mcoirault/arduboy/arduboy.kicad_pcb

## KiCad design arduboy.kicad_pcb (2023-04-20)

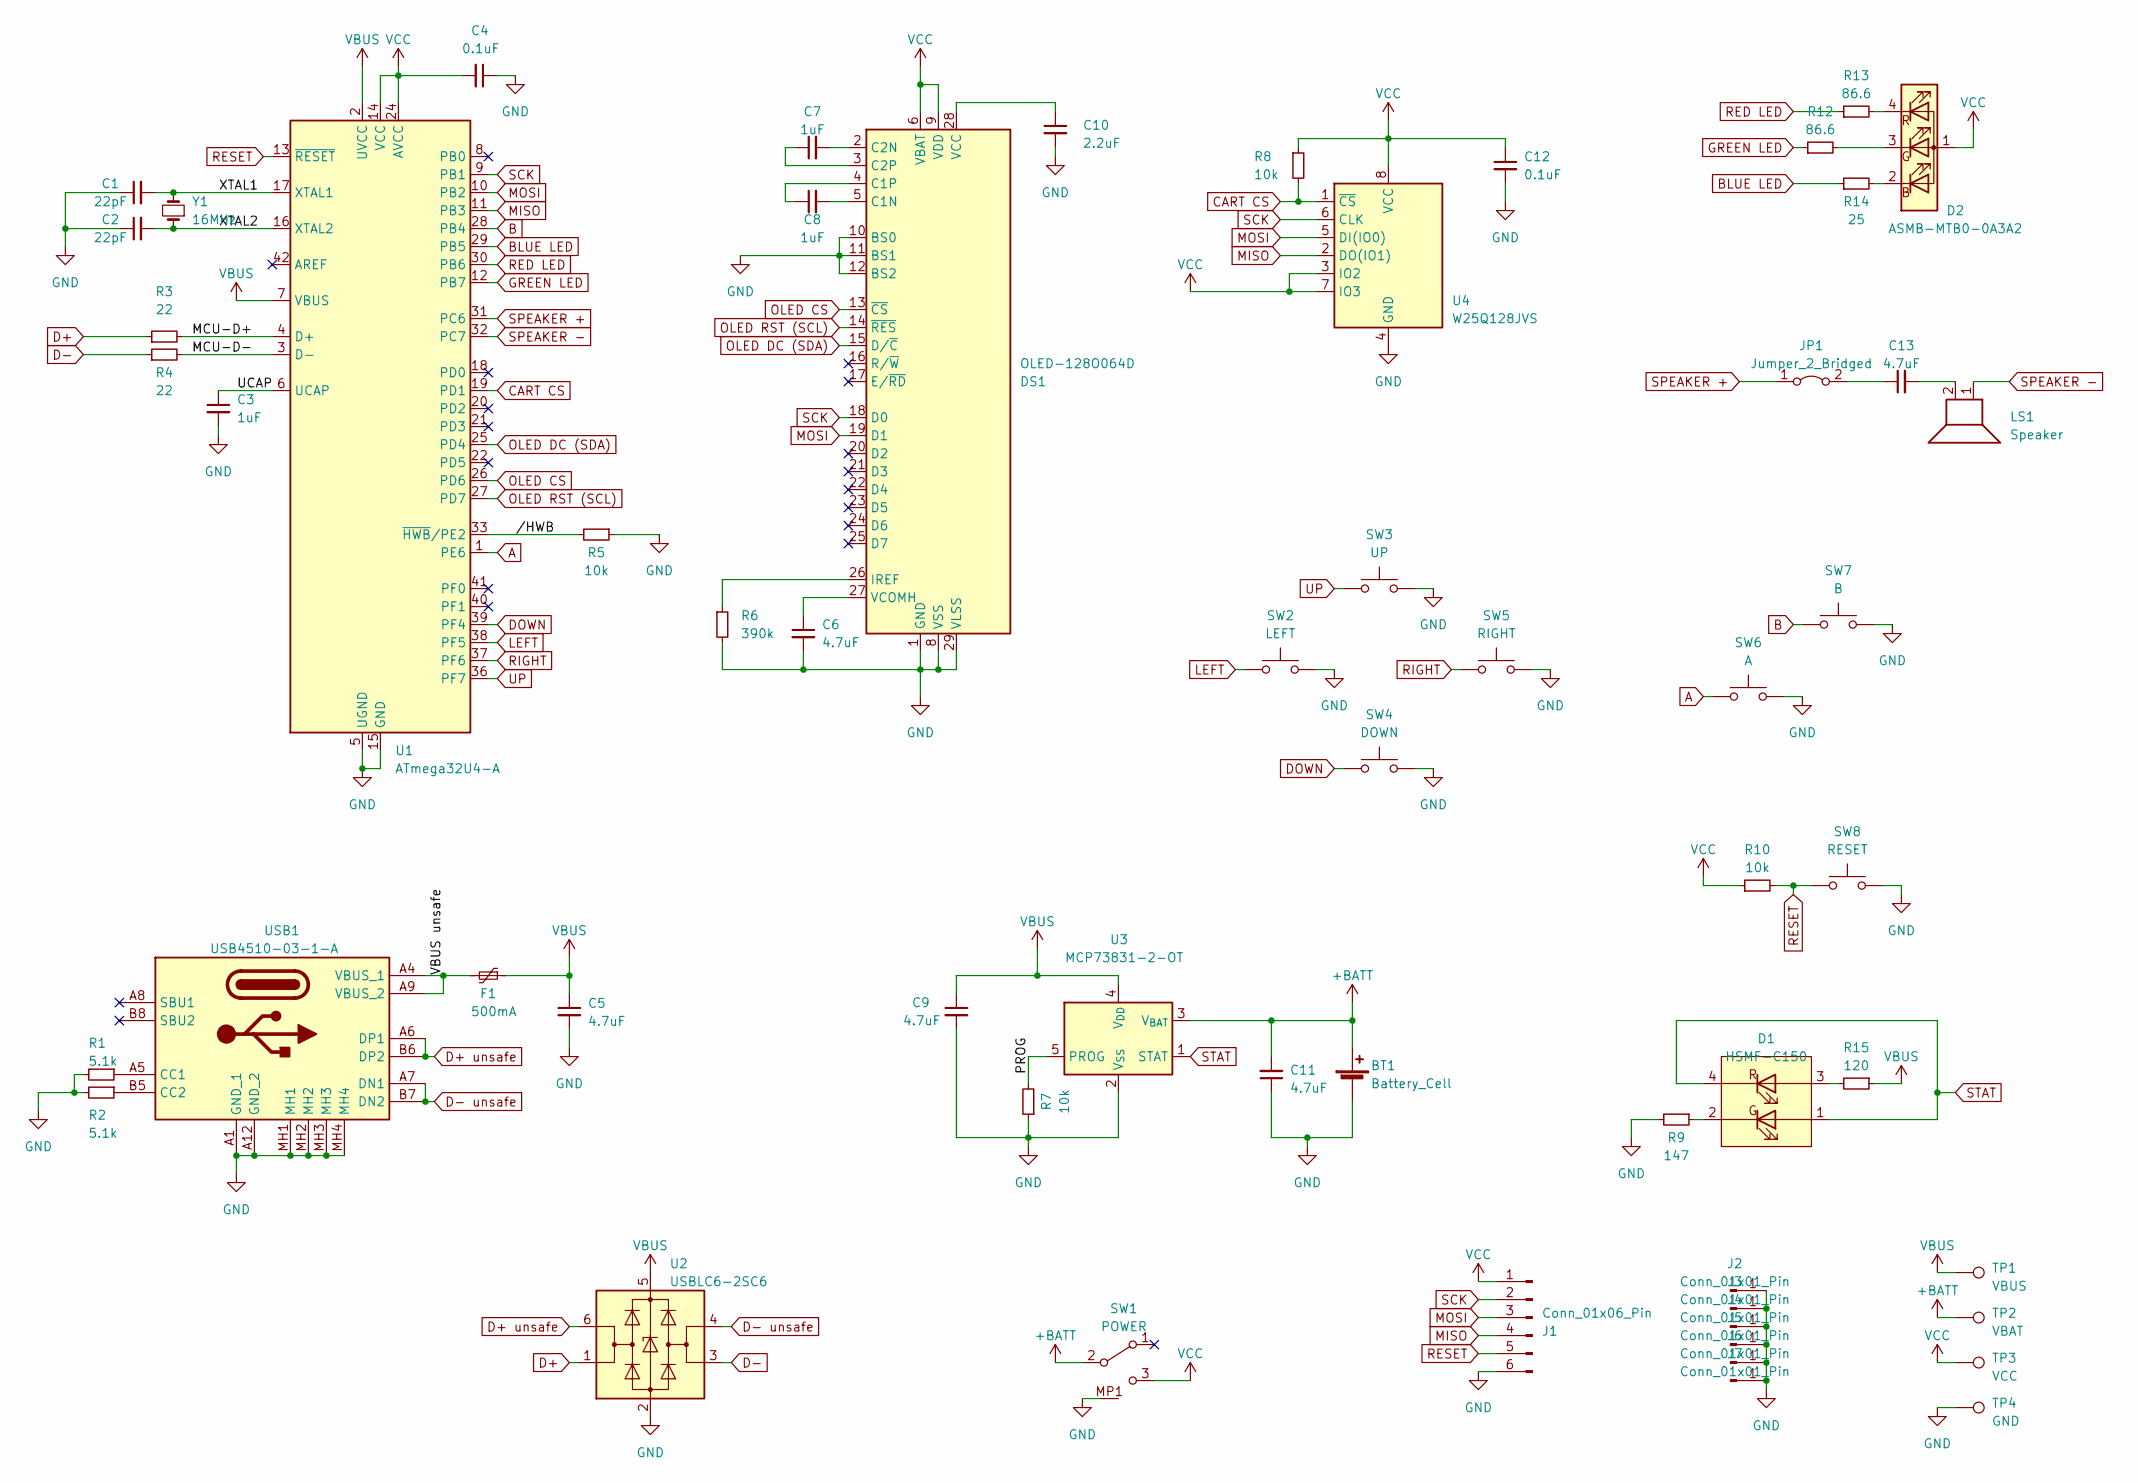
[picture p1: schematic arduboy.kicad_sch]

Parts:
BT1: Battery_Cell; JST_SH_SM02B-SRSS-TB_1x02-1MP_P1.00mm_Horizontal
C1, C2: 22pF; C_1206_3216Metric_Pad1.33x1.80mm_HandSolder ref under the c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; Manufacturer_Part_Number VJ1206A220JXQPW1BC; Mouser Part Number 77-VJ1206A220JXQPBC
C3, C7, C8: 1uF; C_1206_3216Metric_Pad1.33x1.80mm_HandSolder ref under the c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; Manufacturer_Part_Number 1206B105J500CT; Mouser Part Number 791-1206B105J500CT
C4, C12: 0.1uF; C_1206_3216Metric_Pad1.33x1.80mm_HandSolder ref under the c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; Manufacturer_Part_Number GRM3195C1H104JA05D; Mouser Part Number 81-GRM3195C1H104JA5D
C5, C6, C9, C11, C13: 4.7uF; C_1206_3216Metric_Pad1.33x1.80mm_HandSolder ref under the c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; Manufacturer_Part_Number GRM31CR71H475KA12K; Mouser Part Number 81-GRM31CR71H475KA2K
C10: 2.2uF; C_1206_3216Metric_Pad1.33x1.80mm_HandSolder ref under the c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; Manufacturer_Part_Number CL31B225KBHNFNE; Mouser Part Number 187-CL31B225KBHNFNE
D1: HSMF-C150; HSMFC150; Mouser Part Number 630-HSMF-C150
D2: ASMB-MTB0-0A3A2; LED_Avago_PLCC4_3.2x2.8mm_CW; Manufacturer_Part_Number ASMB-MTB0-0B3A2; Mouser Part Number 630-ASMB-MTB0-0B3A2
DS1: OLED-128O064D; OLED_30pins_0.7mm
F1: 500mA; polyfuse_5.1mm; Manufacturer_Part_Number MF-R050; Mouser Part Number 652-MFR050
J1: Conn_01x06_Pin; custom ISP header; Manufacturer_Part_Number M22-2530605; Mouser Part Number 855-M22-2530605
J2, J3, J4, J5, J6, J7: Conn_01x01_Pin; MountingHole_2.2mm_M2_Pad
JP1: Jumper_2_Bridged; Jumper for SMD 1206 bridged
LS1: Speaker; Buzzer_Mallory_AST1109MLTRQ; Manufacturer_Part_Number AST1109MLTRQ; Mouser Part Number 539-AST1109MLTRQ
R1, R2: 5.1k; R_1206_3216Metric_Pad1.30x1.75mm_HandSolder with ref under 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; Manufacturer_Part_Number RMCF1206FT5K10; Mouser Part Number 708-RMCF1206FT5K10
R3, R4: 22; R_1206_3216Metric_Pad1.30x1.75mm_HandSolder with ref under 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; Manufacturer_Part_Number CR1206-FX-22R0ELF; Mouser Part Number 652-CR1206FX-22R0ELF
R5, R7, R8, R10: 10k; R_1206_3216Metric_Pad1.30x1.75mm_HandSolder with ref under 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; Manufacturer_Part_Number RNCP1206FTD10K0; Mouser Part Number 708-RNCP1206FTD10K0
R6: 390k; R_1206_3216Metric_Pad1.30x1.75mm_HandSolder with ref under 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; Manufacturer_Part_Number ESR18EZPF3903; Mouser Part Number 755-ESR18EZPF3903
R9: 147; R_1206_3216Metric_Pad1.30x1.75mm_HandSolder with ref under 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; Manufacturer_Part_Number CR1206-FX-1470ELF; Mouser Part Number 652-CR1206FX-1470ELF
R12, R13: 86.6; R_1206_3216Metric_Pad1.30x1.75mm_HandSolder with ref under 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; Mouser Part Number 660-RK73H2BTTD86R6F
R14: 25; R_1206_3216Metric_Pad1.30x1.75mm_HandSolder with ref under 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; Mouser Part Number 660-RK73H2BTTD25R5F
R15: 120; R_1206_3216Metric_Pad1.30x1.75mm_HandSolder with ref under 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; Manufacturer_Part_Number CR1206-FX-1200ELF; Mouser Part Number 652-CR1206FX-1200ELF
SW1: POWER; PCM12SMTR; Manufacturer_Part_Number PCM12SMTR; Mouser Part Number 611-PCM12SMTR
SW2: LEFT; TS18525SL260SMTTR; Manufacturer_Part_Number TS18-5-15-SL-160-SMT-TR; Mouser Part Number 179-TS18515SL160SMTT
SW3: UP; TS18525SL260SMTTR; Manufacturer_Part_Number TS18-5-15-SL-160-SMT-TR; Mouser Part Number 179-TS18515SL160SMTT
SW4: DOWN; TS18525SL260SMTTR; Manufacturer_Part_Number TS18-5-15-SL-160-SMT-TR; Mouser Part Number 179-TS18515SL160SMTT
SW5: RIGHT; TS18525SL260SMTTR; Manufacturer_Part_Number TS18-5-15-SL-160-SMT-TR; Mouser Part Number 179-TS18515SL160SMTT
SW6: A; TS18525SL260SMTTR; Manufacturer_Part_Number TS18-5-25-SL-260-SMT-TR; Mouser Part Number 179-TS18525SL260SMTT
SW7: B; TS18525SL260SMTTR; Manufacturer_Part_Number TS18-5-25-SL-260-SMT-TR; Mouser Part Number 179-TS18525SL260SMTT
SW8: RESET; 436353045816; Manufacturer_Part_Number 436353045816; Mouser Part Number 710-436353045816
TP1: VBUS; TestPoint_Pad_D2.0mm
TP2: VBAT; TestPoint_Pad_D2.0mm
TP3: VCC; TestPoint_Pad_D2.0mm
TP4: GND; TestPoint_Pad_D2.0mm
U1: ATmega32U4-A; TQFP-44_10x10mm_P0.8mm; Manufacturer_Part_Number ATMEGA32U4-AU; Mouser Part Number 556-ATMEGA32U4-AU
U2: USBLC6-2SC6; SOT-23-6 with dot marker; Manufacturer_Part_Number USBLC6-2SC6; Mouser Part Number 511-USBLC6-2SC6
U3: MCP73831-2-OT; SOT-23-5 with dot marker; Manufacturer_Part_Number MCP73831T-2DCI/OT; Mouser Part Number 579-MCP73831T-2DCIOT
U4: W25Q128JVS; SOIC-8_5.275x5.275mm_P1.27mm; Manufacturer_Part_Number W25Q128JVSIQ TR; Mouser Part Number 454-W25Q128JVSIQTR
USB1: USB4510-03-1-A; USB4510031A; Mouser Part Number 640-USB4510031A
Y1: 16MHz; Crystal_HC46-X_Vertical; Manufacturer_Part_Number ECS-160-20-46X; Mouser Part Number 520-160-20-46X

Connections:
+BATT: BT1.1 (+), C11.2, SW1.2 (B), TP2.1, U3.3 (V_{BAT})
/MCU-D+: R3.2, U1.4 (D+)
/MCU-D-: R4.2, U1.3 (D-)
/PROG: R7.2, U3.5 (PROG)
/UCAP: C3.1, U1.6 (UCAP)
/VBUS unsafe: F1.2, USB1.A4 (VBUS_1), USB1.A9 (VBUS_2)
/XTAL1: C1.2, U1.17 (XTAL1), Y1.2
/XTAL2: C2.2, U1.16 (XTAL2), Y1.1
//HWB: R5.2, U1.33 (~HWB/PE2)
A: SW6.1, SW6.2, U1.1 (PE6)
B: SW7.1, SW7.2, U1.28 (PB4)
BLUE LED: R14.1, U1.29 (PB5)
CART CS: R8.2, U1.19 (PD1), U4.1 (~CS)
D+: R3.1, U2.1 (I/O1)
D+ unsafe: U2.6 (I/O1), USB1.A6 (DP1), USB1.B6 (DP2)
D-: R4.1, U2.3 (I/O2)
D- unsafe: U2.4 (I/O2), USB1.A7 (DN1), USB1.B7 (DN2)
DOWN: SW4.1, SW4.2, U1.39 (PF4)
GND: BT1.2 (-), BT1.MP, C1.1, C2.1, C3.2, C4.1, C5.2, C6.2, C9.2, C10.2, C11.1, C12.2, DS1.1 (GND), DS1.8 (VSS), DS1.10 (BS0), DS1.11 (BS1), DS1.12 (BS2), DS1.29 (VLSS), DS1.30 (GND), J1.6, J2.1, J3.1, J4.1, J5.1, J6.1, J7.1, R1.2, R2.2, R5.1, R6.2, R7.1, R9.2, SW1.MP1, SW1.MP2, SW1.MP3, SW1.MP4, SW2.3, SW2.4, SW3.3, SW3.4, SW4.3, SW4.4, SW5.3, SW5.4, SW6.3, SW6.4, SW7.3, SW7.4, SW8.2, SW8.4, TP4.1, U1.5 (UGND), U1.15 (GND), U1.23 (GND), U1.35 (GND), U1.43 (GND), U2.2 (GND), U3.2 (V_{SS}), U4.4 (GND), USB1.A1 (GND_1), USB1.A12 (GND_2), USB1.MH1, USB1.MH2, USB1.MH3, USB1.MH4
GREEN LED: R12.1, U1.12 (PB7)
LEFT: SW2.1, SW2.2, U1.38 (PF5)
MISO: J1.4, U1.11 (PB3), U4.2 (DO(IO1))
MOSI: DS1.19 (D1), J1.3, U1.10 (PB2), U4.5 (DI(IO0))
unnamed: C13.2, LS1.2
unnamed: D1.2 (GC), R9.1
unnamed: D1.3 (RA), R15.2
unnamed: D2.2 (BK), R14.2
unnamed: D2.3 (GK), R12.2
unnamed: D2.4 (RK), R13.2
unnamed: C8.2, DS1.5 (C1N)
unnamed: C8.1, DS1.4 (C1P)
unnamed: C7.2, DS1.2 (C2N)
unnamed: C7.1, DS1.3 (C2P)
unnamed: DS1.26 (IREF), R6.1
unnamed: C10.1, DS1.28 (VCC)
unnamed: C6.1, DS1.27 (VCOMH)
unnamed: C13.1, JP1.2 (B)
unnamed: R1.1, USB1.A5 (CC1)
unnamed: R2.1, USB1.B5 (CC2)
OLED CS: DS1.13 (~CS), U1.26 (PD6)
OLED DC (SDA): DS1.15 (D/~C), U1.25 (PD4)
OLED RST (SCL): DS1.14 (~RES), U1.27 (PD7)
RED LED: R13.1, U1.30 (PB6)
RESET: J1.5, R10.2, SW8.1, SW8.3, U1.13 (~RESET)
RIGHT: SW5.1, SW5.2, U1.37 (PF6)
SCK: DS1.18 (D0), J1.2, U1.9 (PB1), U4.6 (CLK)
SPEAKER +: JP1.1 (A), U1.31 (PC6)
SPEAKER -: LS1.1, U1.32 (PC7)
STAT: D1.1 (GA), D1.4 (RC), U3.1 (STAT)
UP: SW3.1, SW3.2, U1.36 (PF7)
VBUS: C5.1, C9.1, F1.1, R15.1, TP1.1, U1.2 (UVCC), U1.7 (VBUS), U2.5 (VBUS), U3.4 (V_{DD})
VCC: C4.2, C12.1, D2.1 (A), DS1.6 (VBAT), DS1.9 (VDD), J1.1, R8.1, R10.1, SW1.3 (C), TP3.1, U1.14 (VCC), U1.24 (AVCC), U1.34 (VCC), U1.44 (AVCC), U4.3 (IO2), U4.7 (IO3), U4.8 (VCC)

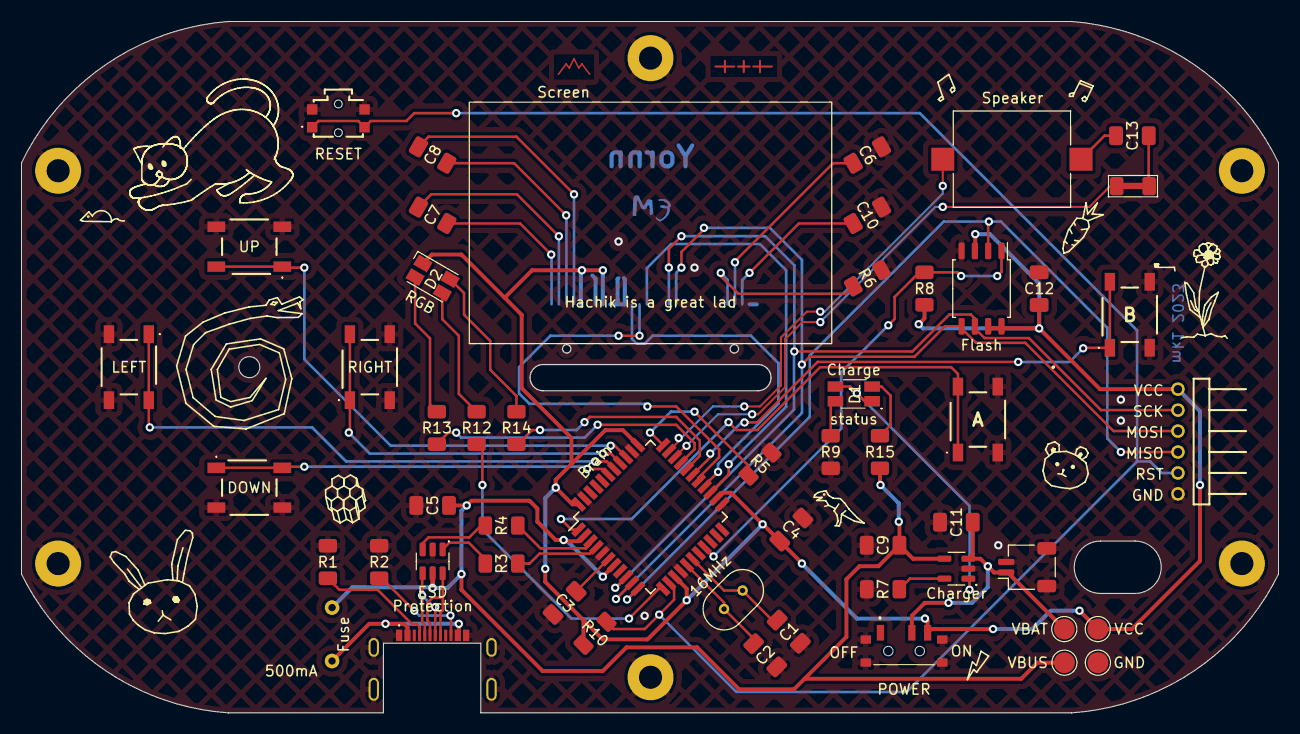
[picture p2: board arduboy.kicad_pcb from above]

Board: 2 copper layers, 120.0 x 66.0 mm, 59 parts (1 on the bottom side), 52 nets.
