mcoirault/arduboy/(commit log)

2023-04-20 Add back silkscreen
    [arduboy.kicad_pcb, arduboy.kicad_sch]
2023-04-20 Fix footprints to use 1210 according to selected components
    [arduboy.kicad_pcb, arduboy.kicad_sch]
